syntaxguild/vibecom/mechanical/audit/README.md

# Assembly audit — v0.7.0

ตรวจเมื่อ 2026-10-17: แบบแยก **8 ชิ้น** เพิ่มฝาหลังตัวถังและถาดอุปกรณ์ถอดได้ รายงานพร้อม hash ของโมเดล/สคริปต์อยู่ใน [assembly-audit.json](assembly-audit.json)

## สิ่งที่เปลี่ยนเพื่อประกอบง่ายขึ้น

- ตัวถังแยกที่ Y=4 มม. พร้อมระยะรอยต่อ 0.35 มม. มีสกรูบริการด้านหลัง 2 จุด และสกรูฐาน 4 จุด
- ถาดมี cradle ESP32 กับแป้น ToF แยกจากฐานเท้า ยึดถาด 2 จุด พร้อมหน้าต่างสาย 18 × 30 มม. และรูรัดสาย 4 ช่อง
- เสาปิดฝาหัวอยู่ X=±34, Z=ศูนย์หัว±18 มม. เปิดทางให้จอเข้าตรงจากด้านหลัง
- ขนาดภายนอกยัง 80 × 66 × 100.8 มม.; แก้ภายในโดยรักษาหน้าตาและฮาร์ดแวร์หลัก

## ขอบเขตการตรวจ

- คู่ envelope ของอุปกรณ์/ชิ้นพิมพ์ 134 คู่ และพื้นที่สำรองหัวเสียบ
- คู่ชิ้นประกอบที่ต้องไม่ซ้อน 8 คู่ พร้อมแนวแสง ToF อ้างอิง 36 เส้น
- วาง ESP32 ลง cradle จากด้านบนขณะถาดอยู่นอกตัว
- เลื่อนชุดถาดผ่านด้านหลังที่เปิดอยู่ และตรวจการครอบเปลือกหน้ารอบฐาน/ถาดที่ประกอบไว้แล้ว
- ปิดฝาหลังตัวถังด้วยการยก 3 มม. ก่อนเลื่อนเข้าแล้วค่อยลดลง
- ทางใส่เซอร์โว ทัช ToF และจอซึ่งเป็นทางตรงจากด้านหลัง
- รูสกรูฐานและผิวรองรับหัวสกรูครบ 4 จุด

ตำแหน่งระหว่างทางเป็นการสุ่มตรวจ ไม่มีการรับรองการเคลื่อนที่ต่อเนื่องหรือการเข้าถึงด้วยมือ/เครื่องมือทุกชนิด โมเดลยังไม่รวม CAD จริงของ horn/spline, นัตทุกตัว และสายไฟทั้งหมด

## สถานะ

`geometry_gate_passed` แสดงผลเฉพาะคู่ตรวจและเส้นทางในรายงาน ส่วน `print_ready: false` คงไว้จนกว่าจะวัดอะไหล่จริงและพิมพ์ทดลองประกอบ ไม่ใช้ผลตรวจในคอมเป็นเปอร์เซ็นต์ความสำเร็จของชิ้นจริง

[Robustness checks](ROBUSTNESS.md) · [Assembly instructions](../ASSEMBLY.md) · [Reference dimensions and manufacturer links](../reference.json)

```sh
blender --background --python-exit-code 1 --python mechanical/audit_assembly.py -- --strict
python mechanical/check_exports.py
```

CI ตรวจรายงานให้ตรงไฟล์ BLEND และ source ปัจจุบัน ไม่ได้ regenerate geometry บน GitHub ประวัติก่อนแก้ยังอยู่ใน [v0.5 baseline](v0.5-baseline.json) และ Git history
