syntaxguild/vibecom/docs/HARDWARE.md

# Hardware and wiring

คู่มือนี้ใช้คำสั่งจากราก repository และสเปกอุปกรณ์เป้าหมายของ Vibecom

## ต่อจอจริง Waveshare 17344 — รุ่นอ้างอิง 2 นิ้ว 8 ขา

| ขาบนจอ | ESP32 |
| --- | --- |
| GND | GND ร่วม |
| VCC | 3V3 |
| CLK | GPIO 14 |
| DIN | GPIO 23 |
| RST | GPIO 33 |
| DC | GPIO 26 |
| CS | GPIO 27 |
| BL | 3V3 เพื่อเปิด backlight |

ใช้ `esp32vibecom` รุ่นนี้มี CS ต้องต่อ GPIO27 จอวางแนวนอน พื้นที่แสดงผล 40.8 × 30.6 มม. และ PCB 58 × 35 มม. อ้างอิง [Waveshare รุ่น 17344](https://docs.waveshare.net/2inch_LCD_Module/) สายต่อเหมือนรุ่น 15867 แต่ต้องใช้โปรไฟล์ที่ตรงกับขนาดจอ

จอ Waveshare 15867 ขนาด 1.3 นิ้วเดิมใช้ `esp32vibecom13`; จอ 7 ขาเดิมใช้ `esp32dev`: SCL/SCK →14, SDA/DIN →23, RES/RST →33, DC →26, BLK →3V3, VCC →3V3, GND →GND และไม่มี CS ไม่ต้องแก้โค้ดเพื่อย้อนใช้แบบเดิม **SDA/SCL ของจอเป็น SPI ไม่ใช่ I²C** ใช้สายสั้นและกราวด์ร่วม

หากจอดำหรือภาพผิด ตรวจสายและไฟก่อน แล้วปรับ `TFT_SPI_HZ`, `TFT_SPI_MODE`, `TFT_INVERT` ต้น `src/main.cpp` ให้ตรงโมดูล เริ่มที่ 40 MHz / SPI_MODE0 / invert=true ลดเหลือ 20 MHz หากสายมีปัญหา SPI ไม่มีการตอบรับว่าจอแสดงภาพสำเร็จ ต้องตรวจภาพจริงด้วย

## เซ็นเซอร์และเซอร์โว

| อุปกรณ์ | ขา | ESP32 |
| --- | --- | --- |
| DFR0030 / TTP223 | VCC / GND / OUT | 3V3 / GND / GPIO 4 |
| Pololu #3415 / VL53L1X (รุ่น v0.4) | VIN / GND | 3V3 / GND |
| Pololu #3415 / VL53L1X (รุ่น v0.4) | SDA / SCL | GPIO 21 / GPIO 22 |
| HC-SR04 (โปรไฟล์เดิม) | TRIG / ECHO | GPIO 5 / GPIO 19 |
| HC-SR04 (โปรไฟล์เดิม) | VCC / GND | 5V / GND |
| SG90 Digital (รุ่นอ้างอิง) / Servo เดิม | PWM | GPIO 18 |
| Servo | V+ / GND | แหล่งจ่าย 5V สำหรับมอเตอร์ / GND ร่วม |

ตั้ง TTP223 เป็น **Direct / Momentary + Active HIGH** ไม่ใช้ Toggle ตรวจจัมเปอร์ตามโมดูล และปล่อยแผ่นสัมผัสว่างอย่างน้อย 1 วินาทีตอนเปิดเครื่อง โค้ดใช้ `INPUT_PULLDOWN` และกรองสัญญาณนิ่ง 25 ms แยกแตะครั้งเดียว แตะสองครั้ง และแตะค้างได้ แต่ไม่แยกทิศทางหรือความแรงการลูบ

**รุ่นปัจจุบัน:** ใช้ carrier Pololu #3415 ที่มี regulator/level shifter ไม่ใช่ชิปเปล่า จ่าย VIN จาก **3V3** เพื่อให้ pull-up ของ SDA/SCL อยู่ที่ 3.3V ขา VDD เป็นเอาต์พุต regulator ไม่ใช่ขา VIN ขา XSHUT/GPIO1 ไม่ต้องต่อเมื่อใช้ตัวเดียว ที่อยู่ I²C เริ่มต้น `0x29`; GPIO5/19 ไม่ใช้ในโปรไฟล์ ToF [ข้อมูลและผังวงจรจาก Pololu](https://www.pololu.com/product/3415)

เริ่มทำงานต้องเห็น `Distance sensor=VL53L1X READY` โค้ดใช้ Long mode, timing budget 50 ms, วัดทุก 80 ms และตรวจ data-ready ทุก 10 ms แล้ว `read(false)` จึงไม่รอรอบวัดในลูปภาพ; I²C transaction ยังใช้เวลาจริงและตั้ง timeout 10 ms รับเฉพาะ `RangeValid` ในช่วง 40–4000 mm แล้วแปลงเป็น cm ก่อนเข้าตัวกรองเดิม ค่าผิดพลาดจะไม่กลายเป็นระยะศูนย์; เมื่อไม่มีค่าถูกต้องเกิน 400 ms จะขึ้น `Distance=unavailable` และกลับพฤติกรรมไม่มีเป้าหมาย ทัชยังใช้ได้ ถ้าเริ่มเซ็นเซอร์ไม่สำเร็จจะรายงาน ERROR ให้ตรวจสายแล้วรีสตาร์ต หลังเซ็นเซอร์รีเซ็ตหรือไฟตกขณะทำงานให้รีสตาร์ตเพื่อเริ่มเซ็นเซอร์ใหม่ ไม่ได้ทำ blocking auto-init ในลูปภาพ

ระยะ 4 เมตรเป็นค่าสูงสุดตามสภาพแสง/เป้าหมาย ไม่รับรองทุกพื้นผิว ช่องที่อกเป็นรูเปิด ไม่ปิดด้วยพลาสติกพิมพ์ทึบหรือกระจกที่ยังไม่ได้คาลิเบรต ไลบรารี [Pololu VL53L1X 1.3.1](https://github.com/pololu/vl53l1x-arduino) ที่ pin ไว้ไม่ได้จัดการ calibration สำหรับ cover glass ให้ครบ ต้องทดสอบแสง วัตถุ และช่องเปิดจริงก่อนประกอบ

**ย้อนใช้ HC-SR04:** ใช้ `pio run -e esp32vibecom_sonar -t upload` และต่อ TRIG5/ECHO19 ตามรุ่นเดิม ทั้ง ToF และ sonar จอ 2 นิ้วใช้ namespace `vibecom2` และรูปแบบค่าตั้งเดิม จึงเก็บคาลิเบรตเซอร์โว/threshold ไว้ ไม่ลบ NVS เมื่อเปลี่ยนเซ็นเซอร์ ตัวถัง HC-SR04 อยู่ใน commit `a1484a8`; ตัวถัง v0.4 ไม่มีรูรับกระบอกคู่แล้ว

HC-SR04 จริงในโปรไฟล์เก่าส่ง ECHO 5V ต้องลดระดับก่อนเข้า ESP32 เช่น ECHO → R 1 kΩ → GPIO 19 และ GPIO 19 → R 2 kΩ → GND ผัง Wokwi ปัจจุบันใช้ VL53L1X แล้ว จึงไม่มีสาย ECHO

เซอร์โวใช้แหล่งจ่ายที่จ่ายกระแสพอและกราวด์ร่วม รุ่นอ้างอิง SG90 Digital เริ่ม PWM 1000–2000 µs และช่วงคำสั่งคอ 15/75/135 จำกัดไม่เกิน 150 ตามรุ่น; แบบเดิมยังใช้ 500–2500 µs และ 0/90/180 ปรับตามกลไกจริงใน `src/hardware.h` ต้องคาลิเบรตกับเซอร์โวจริง จอไม่ได้ใช้ขาทัช ไม่มีลำโพงหรือ buzzer

จอ ILI9341 ใน Wokwi ต่อ MOSI → 23, SCK → 14, D/C → 26, CS → 27, VCC → 3V3 และ GND ร่วม ไม่ต่อ MISO ส่วน RST และ backlight ไม่ได้จำลองตามเอกสาร Wokwi
