syntaxguild/vibecom/mechanical/audit/ROBUSTNESS.md

# Digital robustness checks — v0.7.0

[ผลดิบพร้อม fingerprint](robustness.json) · [Assembly audit](README.md)

| การตรวจ | ขอบเขต |
| --- | --- |
| Head yaw | −60 ถึง +60° ทุก 10° ทั้งตำแหน่งปกติและหัวต่ำลง 0.4 มม.; ตรวจเปลือกหัวเทียบทั้งเปลือกหน้ากับฝาหลังตัวถัง |
| Position sensitivity | ขยับ ESP32 PCB, header ล่าง, PCB ToF และเคส SG90 ทีละแกน ±0.2 / ±0.4 มม. |
| Base screws | หัวตัวอย่างกว้าง 4 สูง 2 มม.; ทางใส่ 18 ตำแหน่งต่อจุด จำนวน 4 จุด |
| Head closure | แกนตัวอย่างขนาด 2 × 16 มม. จำนวน 4 จุด เทียบพื้นที่อุปกรณ์ |
| Tray closure | แกน 2 × 5 มม. กับหัวกว้าง 4 สูง 2 มม. จำนวน 2 จุด |
| Rear body closure | แกน 2 × 25 มม. กับหัวกว้าง 4 สูง 2 มม. จำนวน 2 จุด |

การดัน PCB ToF ไปด้านหน้า 0.4 มม. ชน front stop ตามตั้งใจ เพราะตำแหน่งนั่งเผื่อประมาณ 0.24 มม. เป็นการตรวจตัวหยุด ไม่ใช่ตำแหน่งประกอบที่อนุญาต รายงานแยกกรณีนี้จากการชนที่ไม่ตั้งใจ

หัวสกรูและแกนเป็นรูปทรงตัวอย่าง ไม่ใช่การรับรองสกรู M2 ทุกชนิด เกลียว ความแข็งแรง หรือแรงขัน การตรวจไม่ได้รวมสกรูจอ นัต servo/adapter และ horn จริงครบชุด

การขยับทีละแกนไม่ใช่การจำลองเครื่องพิมพ์จริง ไม่รวมหลายแกนพร้อมกัน การหดตัว ความฝืด หรือสายระหว่างหมุน จำนวนกรณีที่ผ่านจึงไม่ใช่เปอร์เซ็นต์โอกาสประกอบสำเร็จ

สิ่งที่ยังต้องทดลอง: LCD stack และตำแหน่ง active area, connector จริง, horn/spline, การงอสาย การรับน้ำหนัก/แรงบิด ทัชผ่านพลาสติก ความร้อน และการสึกหรอ

```sh
blender --background --python-exit-code 1 --python mechanical/check_robustness.py -- --strict
python mechanical/check_exports.py
```
