syntaxguild/vibecom/docs/README.th.md

# Vibecom — เพื่อนตัวเล็กบนโต๊ะ

[English overview](../README.md) · [ดาวน์โหลด v0.7.0](https://github.com/syntaxguild/vibecom/releases/tag/v0.7.0)

Vibecom จากโมเดลจริง

Vibecom เป็นหุ่นตั้งโต๊ะที่สื่ออารมณ์ผ่านดวงตาและการหันหัว ใช้ ESP32 อ่านระยะกับการสัมผัส แล้วตอบสนองด้วยท่าทางที่ออกแบบไว้ ทำงานในเครื่องด้วย state machine ไม่ต้องใช้ LLM หรือบริการคลาวด์

มี 5 อารมณ์: Idle, Happy, Angry, Love และ Sleepy แตะครั้งเดียวเพื่อเรียกความสนใจ แตะสองครั้งเพื่อเล่น แตะค้างเพื่อแสดงความรัก และมี 4 บุคลิกให้ปรับผ่าน Serial พร้อมบันทึกค่าข้ามรีสตาร์ต

## เริ่มจากตรงไหน

| สิ่งที่ต้องการ | เอกสาร |
| --- | --- |
| ต่อบอร์ด จอ เซ็นเซอร์ และเซอร์โว | [การต่อวงจร](HARDWARE.md) |
| ดูพฤติกรรม คำสั่ง Serial และระบบภาพ | [เฟิร์มแวร์](FIRMWARE.md) |
| Build / Wokwi / ทดสอบ | [Development](DEVELOPMENT.md) |
| เข้าใจแนวคิดและการออกแบบระบบ | [Architecture](ARCHITECTURE.md) |
| ดูว่าตรวจอะไรแล้วบ้าง | [Validation](VALIDATION.md) |
| เปิดโมเดลและเลือกไฟล์พิมพ์ | [คู่มือ 3D](../mechanical/README.md) |
| ดูลำดับประกอบและสกรู | [Assembly](../mechanical/ASSEMBLY.md) |
| ดูสิ่งที่เปลี่ยนในแต่ละรุ่น | [Changelog](../CHANGELOG.md) |

## สถานะปัจจุบัน

รุ่น **0.7.0** มีเฟิร์มแวร์ที่ build ได้ครบ 5 โปรไฟล์ มี host tests, custom chip VL53L1X สำหรับ Wokwi และโมเดลแยก 8 ชิ้น พร้อม BLEND/GLB/STL ขนาดรวม 80 × 66 × 100.8 มม.

แยกฝาหลังตัวถังกับถาดบอร์ดแล้ว สามารถวางบอร์ดและเตรียมสายบนถาดนอกตัวก่อนปิดเปลือก มีช่องร้อยสายกลางและช่องรัดสาย 4 ช่อง ส่วนจอใส่ตรงจากหลังหัวได้ อ่านลำดับและขนาดสกรูทดลองใน [คู่มือประกอบ](../mechanical/ASSEMBLY.md)

ภาพแนว blueprint ของรุ่นปัจจุบัน

ภาพ blueprint ใช้ AI สร้างจากภาพ CAD ปัจจุบันเพื่ออธิบายงาน ไม่ใช่แบบผลิต ให้ยึด STL และมิติใน reference เป็นหลัก

ผ่านการตรวจการชนในคอม ทางใส่ตัวอย่าง การหมุนหัว และทางใส่หัวสกรูตามขอบเขตที่ระบุแล้ว ผู้ใช้ยืนยันว่า Wokwi เปิดชิป VL53L1X และรันได้ แต่ยังไม่ได้พิมพ์หรือประกอบกับอะไหล่จริง จึงต้องวัดหัวเสียบ ความหนาจอ horn และเดินสายจริงก่อนสั่งพิมพ์ชุดสำเร็จ ผลตรวจในคอมไม่ใช่เปอร์เซ็นต์โอกาสประกอบสำเร็จ

## คำสั่งเริ่มต้น

```sh
pio run -e esp32vibecom
pio run -e esp32sim
```

โปรไฟล์แรกสำหรับฮาร์ดแวร์อ้างอิง โปรไฟล์หลังสำหรับ Wokwi ใน VS Code อ่านวิธีต่อไฟและกราวด์ร่วมใน [Hardware](HARDWARE.md) ก่อนอัปโหลดลงบอร์ดจริง
