syntaxguild/vibecom/docs/FIRMWARE.md

# Firmware behavior and rendering

## สีหน้าและพฤติกรรม

| เงื่อนไข | ภาพใบหน้า | คอ |
| --- | --- | --- |
| Idle: อยู่นอกช่วงทักทาย | ตาทึบสีฟ้ามินต์ กลอกตา หายใจและกะพริบ | ตามสายตาเล็กน้อย |
| Sleepy: ไม่มีปฏิสัมพันธ์ตามเวลาที่ตั้ง (เริ่ม 10 วินาที) | ตาปรือสีม่วงหม่น มี Zz ลอยขึ้น | กลับ `neck_center` |
| Happy: ระยะอยู่ระหว่าง `near` และ `far` | ตายิ้มกว้างสีทอง ขยับกระฉับกระเฉง แก้มอุ่น | ส่ายนุ่มนวล / ทักทายเมื่อเดินเข้ามา |
| Angry: ใกล้กว่า `near` | ตาคมสีคอรัล สั่นเบา ๆ ไม่มีตายิ้ม แก้ม หรือหัวใจจากอารมณ์ก่อนหน้า | หันหนีถึง `neck_max` ที่คาลิเบรตไว้ |
| Love: ขณะสัมผัส สำคัญสูงสุด | ตาปรือยิ้มอ่อนสีชมพู เอนหน้าและมีแก้ม ต่างจาก Happy | หันใกล้ `neck_center + 8°` ขยับช้า ๆ ±3° ภายในช่วงคอ |
| ไม่มีค่าระยะที่ถูกต้องต่อเนื่อง | คงระยะเดิมได้ไม่เกิน 400 ms ก่อนเปลี่ยนกลับ Idle ยกเว้น Love / ท่าเล่น | ตามโหมดปัจจุบัน |

ระยะใช้ค่ากลางของ 3 ตัวอย่าง (วัดทุก 80 ms) และยืนยันโซนใหม่ต่อเนื่อง 160 ms ค่าเริ่มต้นเข้า Angry เมื่อ <15 cm และออกเมื่อ ≥17 cm เข้า Happy เมื่อ ≤50 cm และออกเมื่อ >53 cm จึงไม่สลับสีหน้าไปมาที่ขอบเขต ถ้าสัญญาณหายครบ 400 ms จะทิ้งหน้าต่างเก่าและรอ 3 ตัวอย่างใหม่ การเปลี่ยนอารมณ์หลังสัญญาณหายยังผ่านช่วงยืนยัน 160 ms ด้วย

การเข้าใกล้ภายใน `far` สัมผัส หรือระยะที่กรองแล้วเปลี่ยนจากจุดอ้างอิงอย่างน้อย 4 cm ปลุกจากอาการง่วง การเอนหน้าเป็นภาพบนจอ เซอร์โวหนึ่งตัวใช้หันคอ ไม่ได้ติดตามตำแหน่งซ้าย–ขวาของคน

| การสัมผัส / เหตุการณ์ | พฤติกรรม |
| --- | --- |
| แตะสั้น <500 ms ครั้งเดียว | รอ 320 ms หลังปล่อยเพื่อแยกจากสองครั้ง แล้วเงยตาและหันคอเล็กน้อย 0.9 วินาที |
| แตะสั้นสองครั้ง เริ่มครั้งที่สองภายใน 320 ms หลังปล่อยครั้งแรก | เล่นด้วย ตาสีทองและส่ายคอ 1.8 วินาที |
| แตะค้าง ≥500 ms | Love ระหว่างแตะ และค้างต่อ 1.2 วินาทีหลังปล่อยก่อนค่อย ๆ คลายท่า |
| เดินเข้าช่วง Happy จาก Idle | เหลือบมองแล้วส่ายคอทักทาย 1.6 วินาที เว้นอย่างน้อย 8 วินาทีก่อนทักครั้งใหม่ |
| ปลุกจากหลับ | ค่อย ๆ ลืมตา 1.1 วินาที |

ขณะแตะทุกแบบจะเป็น Love ทันทีหลัง debounce การแตะสั้นไม่ค้าง Love 1.2 วินาทีหลังปล่อย ท่าเล่น/ทักทาย/สนใจถูกยกเลิกเมื่อเข้า Angry และการสัมผัสครั้งใหม่ขัดจังหวะท่าเดิมได้

## ตั้งค่าผ่าน Serial และจำค่าหลังรีสตาร์ต

เปิด Serial Monitor ที่ 115200 baud ส่งคำสั่ง ASCII ทีละบรรทัดด้วย Enter (`LF` หรือ `CRLF`) ไม่เกิน 95 ตัวอักษร:

```text
help
show
profile affectionate
set sleep 15
set near 12
set far 60
set neck_min 30
set neck_max 135
set neck_center 75
save
```

| คำสั่ง | ความหมาย |
| --- | --- |
| `profile normal` | ระยะ 15/50 cm หลับหลัง 10 วินาที |
| `profile affectionate` | ขี้อ้อน ระยะ 12/65 cm หลับหลัง 10 วินาที |
| `profile sleepy` | ขี้เซา หลับหลัง 6 วินาที และส่ายคอ Happy เบาลง ระยะ 15/50 cm |
| `profile grumpy` | ขี้หงุดหงิด ระยะ 22/45 cm หลับหลัง 10 วินาที |
| `set sleep N` | เวลาหลับ 3–600 วินาที |
| `set near N`, `set far N` | `near` 5–80 cm, `far` ไม่เกิน 200 cm และต้องห่าง `near` อย่างน้อย 5 cm |
| `set neck_min N`, `set neck_center N`, `set neck_max N` | ค่าจำนวนเต็ม 0–150 สำหรับรุ่นอ้างอิง / 0–180 แบบเดิม ต้องเรียง `min < center < max` |
| `show` / `help` | แสดงค่าปัจจุบัน / คำสั่ง |
| `save` | บันทึกค่าปัจจุบันใน NVS ด้วย Preferences |
| `reset` | คืนค่าเริ่มต้นใน RAM; ส่ง `save` อีกครั้งหากต้องการบันทึกค่าเริ่มต้น |

ค่าที่แก้มีผลทันที แต่เขียน flash เฉพาะเมื่อส่ง `save` เท่านั้น รุ่น 2 นิ้วใช้ namespace `vibecom2`, รุ่น 1.3 นิ้วใช้ `vibecomref`, แบบ 7 ขาใช้ `deskbot` เพื่อเก็บคาลิเบรตแต่ละรุ่นแยกกัน `profile` เปลี่ยนระยะและเวลาหลับ แต่เก็บมุมคอที่คาลิเบรตไว้ คำสั่งผิด/ค่าผิดช่วงถูกปฏิเสธทั้งคำสั่ง บัฟเฟอร์เต็มจะทิ้งทั้งบรรทัด ข้อมูลที่บันทึกใช้รูปแบบมีเวอร์ชันใน key เดียวและตรวจความถูกต้องเมื่อโหลด หากไม่มีข้อมูลหรืออ่านไม่ได้จะใช้ค่าเริ่มต้น

ทุกท่าถูกจำกัดให้อยู่ในช่วงคอที่ตั้งไว้ รวมมุมเริ่มต้นตอนเปิดเครื่อง ปรับช่วงนี้ให้เหมาะกับกลไกก่อนใช้งานจริง การส่งคำสั่งหรือ `save` อาจหยุดภาพชั่วครู่ จึงประมวลผลเฉพาะช่วงที่ไม่ได้จับ ECHO

ทุกโหมดไม่มีปากเสี้ยววงกลม ใช้ทรงตา สี และการขยับสื่ออารมณ์แทน สถานะ Angry คุมตาทันที ไม่รอ `angryBlend` เกิน 0.5 และระงับตายิ้ม หัวใจ แก้มจากค่า Happy/Love ที่กำลังจางออก

## ความลื่นและหน่วยความจำ

วาดด้วย Adafruit GFX ลง indexed canvas สองชุด ชุดละ 240×160 = 38,400 bytes รวม **76,800 bytes ที่จองคงที่ใน RAM ตั้งแต่ build** ไม่ใช้ `malloc()` จองบัฟเฟอร์ก้อนใหญ่ใน global constructor จึงไม่มีเงื่อนไขจอถูกปิดจากการจองก้อนนั้นล้มเหลวแบบรุ่นก่อน ตัวเลข RAM ตอน build รวมบัฟเฟอร์ทั้งสองแล้ว

แต่ละเฟรมมี palette 5 สี เก็บเป็น RGB565 เต็มความแม่นยำ รวม 20 bytes สำหรับสองเฟรม ก่อนส่งจอแปลงดัชนีสีครั้งละ 8 แถวตรรกะ รุ่น 2 นิ้วขยาย 4:3 เป็นแถบ 320×10/11 pixel ใช้บัฟเฟอร์ RGB565 สูงสุด 7,040 bytes รวมพื้นที่ pixel / palette / ส่งภาพ **83,860 bytes** บวก metadata เล็กน้อย; รุ่นจอเดิมใช้บัฟเฟอร์ 3,840 bytes รวม 80,660 bytes ความละเอียด สี และเอฟเฟกต์เดิมคงอยู่ ไม่ได้ลดเป็นสี RGB332

พื้นที่ตรรกะใบหน้า 240×160 ขยายเป็น 320×214 กลางจอ 320×240 สำหรับจอ 2 นิ้ว; รุ่น 1.3 นิ้วยังเป็น 240×160 กลางจอ 240×240 พื้นที่ดำรอบหน้าล้างครั้งเดียว ภาพที่กำลังส่งไม่ถูกแก้ ขณะอีกบัฟเฟอร์วาดเฟรมใหม่ จึงไม่เกิดเฟรมดำจากการ clear จอแล้ววาดทีละชิ้น

เปรียบเทียบทั้งดัชนีและ palette กับภาพที่ส่งครบแล้วก่อนนำบัฟเฟอร์เก่ากลับมาวาด จึงยังส่งสีใหม่แม้ทรงตาไม่เปลี่ยน ส่งเฉพาะแถบที่เปลี่ยนผ่าน hardware SPI รุ่น 2 นิ้วครั้งละ 10/11 แถว = 6,400/7,040 bytes เวลาบิตบนสายประมาณ **1.28–1.41 ms ที่ 40 MHz** ต่อช่วง กรณีเปลี่ยนทั้งพื้นที่หน้าคือประมาณ **27.39 ms**; รุ่นจอเดิม 0.77 ms ต่อแถบ และ 15.36 ms ทั้งหน้า ยังไม่รวมเวลาวาด แปลงสี เรียกไลบรารี และบริการอินพุต HC-SR04 จับ ECHO ด้วย interrupt เริ่มวัดทุก 80 ms และไม่แทรก SPI/Serial ระหว่าง TRIG 10 µs

เป้าหมายสร้างภาพตรรกะ 60 Hz แต่ **ไม่รับรองจอจริง 60 FPS** จอ 2 นิ้วที่เปลี่ยนภาพเต็มพื้นที่ถูกจำกัดด้วยเวลาสาย SPI ประมาณ 36 ภาพ/วินาที ก่อนรวม overhead ต้องวัดกับโมดูลและสายจริง การส่งแถบไม่ได้ซิงก์ TE ของจอ จึงอาจมีรอยฉีกขณะเคลื่อนไหว Simulator ไม่ใช้วัดความเร็วฮาร์ดแวร์

Serial แสดง `FPS draw` (สร้างภาพ), `TFT` (ภาพเป้าหมายที่แสดงครบ รวมภาพที่เหมือนเดิมจนไม่ต้องส่งซ้ำ), `skipped` (เฟรมใหม่แทนเฟรมที่ยังไม่เริ่มส่ง) และ `SPI max` (เวลาส่งช่วงที่นานที่สุดตั้งแต่เปิดเครื่อง) ค่า TFT เป็นอัตราภาพเป้าหมายที่สำเร็จ ไม่ใช่อัตรา refresh ภายในแผง LCD
