syntaxguild/vibecom/mechanical/exports/05_base_cover.stl

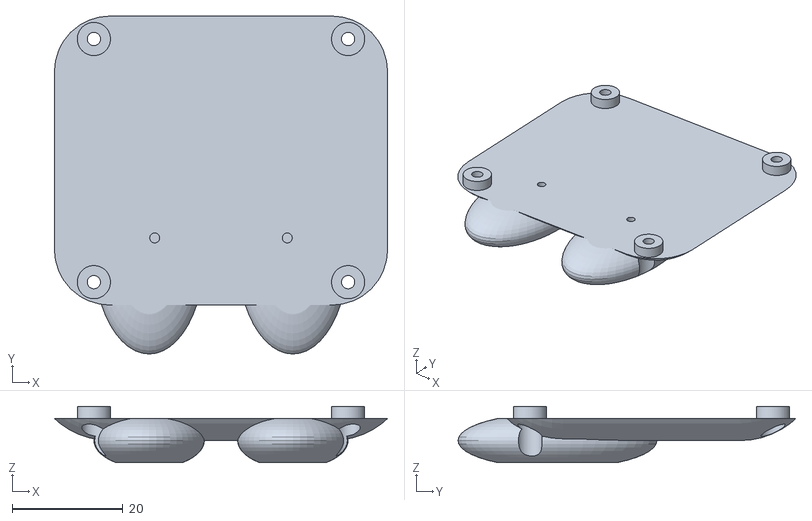
[picture p9: CAD file, 2026-10-17]
mechanical/exports/05_base_cover.stl
60.3 x 61.2 x 10.2
