syntaxguild/vibecom/mechanical/exports/02_head_front.stl

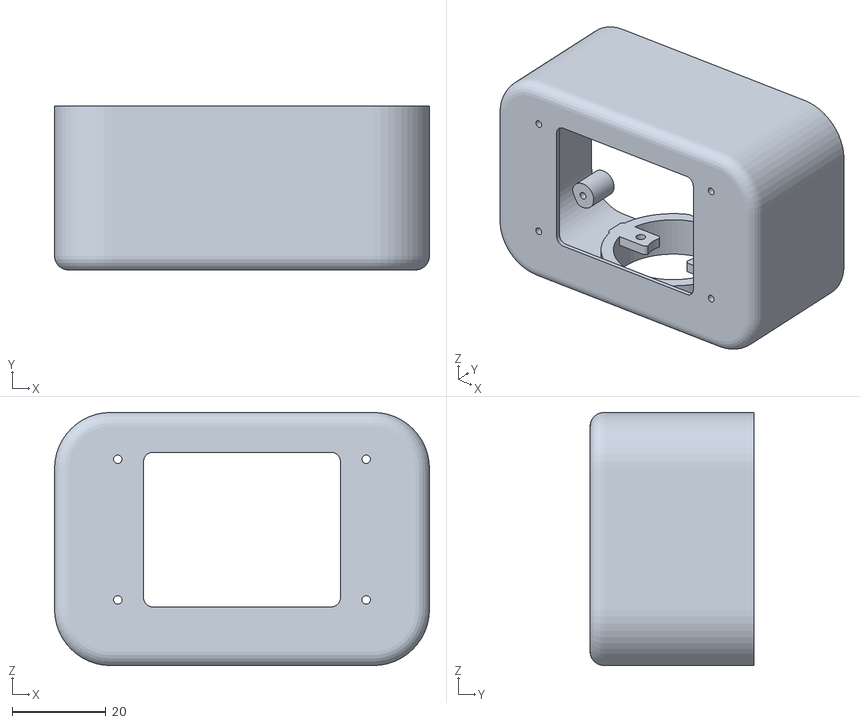
[picture p10: CAD file, 2026-10-17]
mechanical/exports/02_head_front.stl
80.0 x 35.0 x 54.0
