syntaxguild/vibecom/mechanical/exports/07_body_rear.stl

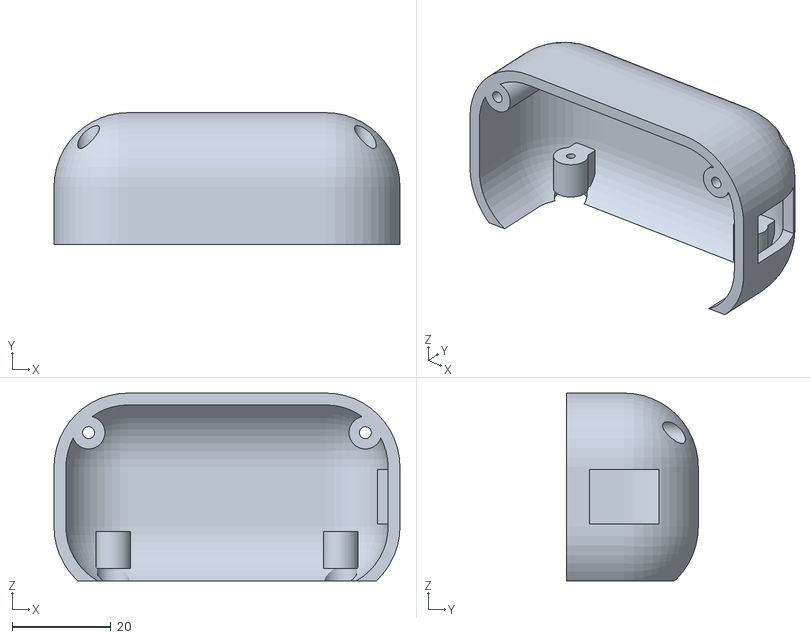
[picture p11: CAD file, 2026-10-17]
mechanical/exports/07_body_rear.stl
70.0 x 26.7 x 38.0
