syntaxguild/vibecom/mechanical/exports/08_electronics_tray.stl

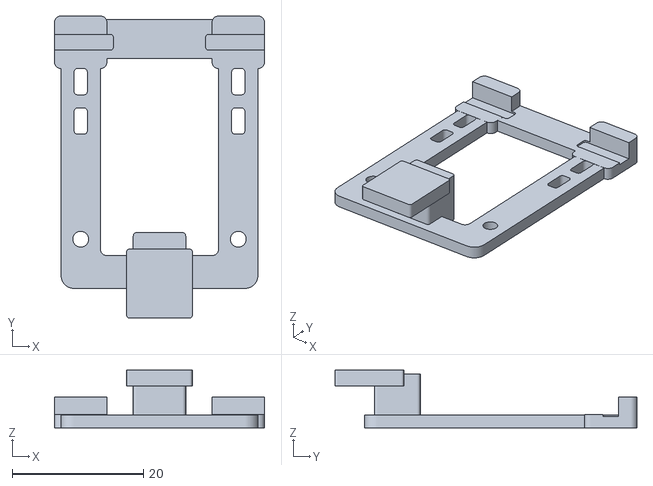
[picture p12: CAD file, 2026-10-17]
mechanical/exports/08_electronics_tray.stl
32.0 x 46.0 x 8.80
