syntaxguild/vibecom/mechanical/exports/01_head_rear.stl

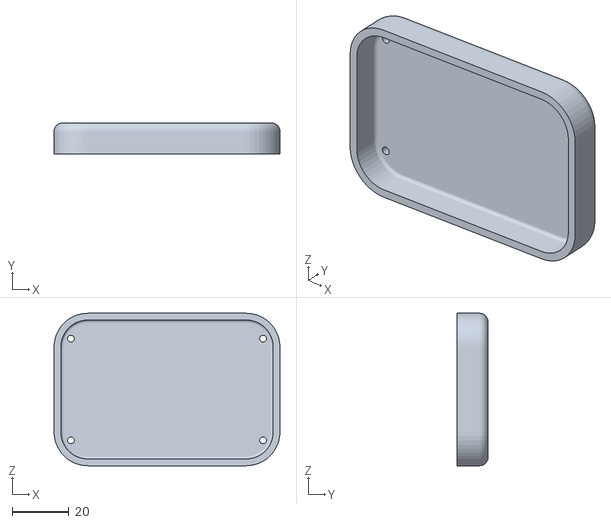
[picture p13: CAD file, 2026-10-17]
mechanical/exports/01_head_rear.stl
80.0 x 11.0 x 54.0
