syntaxguild/vibecom/mechanical/exports/04_body_shell.stl

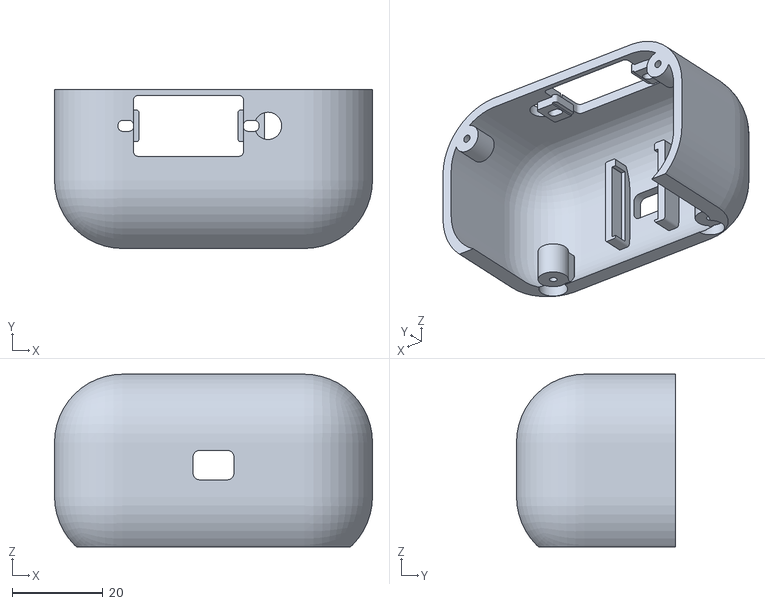
[picture p14: CAD file, 2026-10-17]
mechanical/exports/04_body_shell.stl
70.0 x 35.0 x 38.0
