syntaxguild/vibecom/mechanical/exports/03_face_insert.stl

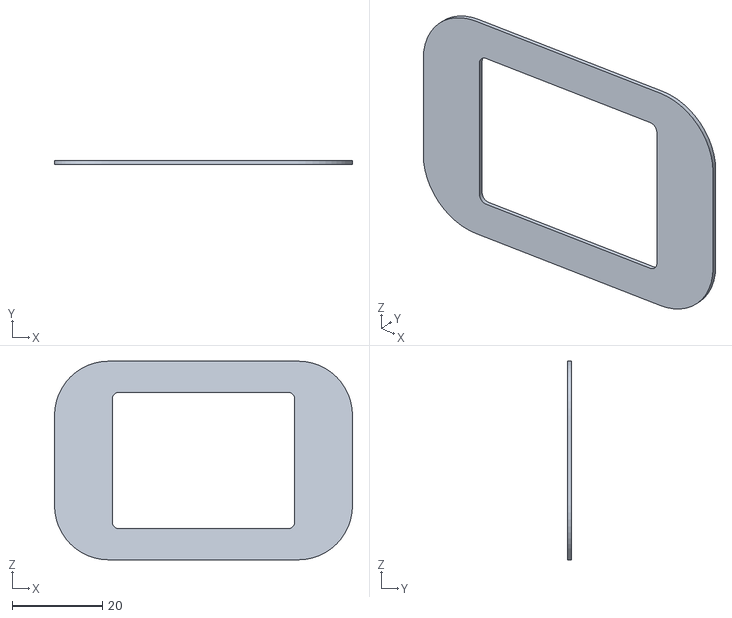
[picture p15: CAD file, 2026-10-16]
mechanical/exports/03_face_insert.stl
66.0 x 0.8 x 44.0
