syntaxguild/vibecom/mechanical/exports/06_neck_horn_adapter.stl

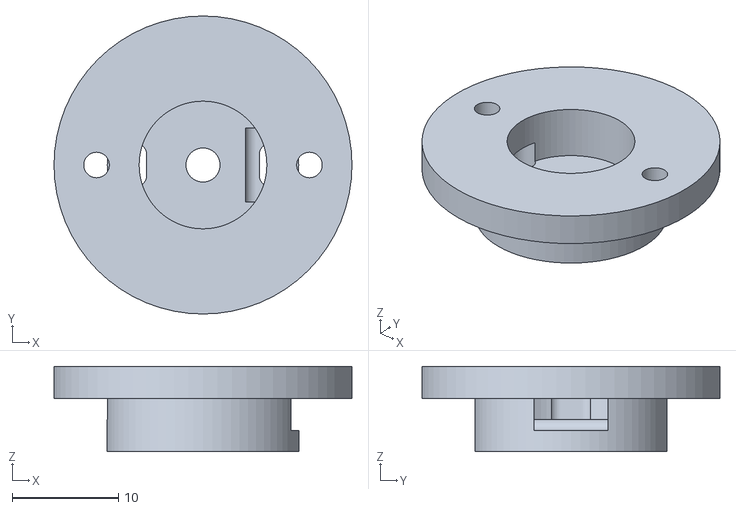
[picture p16: CAD file, 2026-10-16]
mechanical/exports/06_neck_horn_adapter.stl
28.0 x 28.0 x 8.00
