syntaxguild/vibecom/(list of files, cad)

Other CAD files:
mechanical/exports/vibecom.blend
