syntaxguild/vibecom/mechanical/ASSEMBLY.md

# Vibecom v0.7.0 — ประกอบและเปิดซ่อม

ใช้ STL ใหม่ทั้ง **8 ชิ้น** หน่วยมิลลิเมตร scale 100% รุ่นนี้เพิ่มฝาหลังตัวถังและถาดอุปกรณ์ ห้ามผสมฐาน/ฝาหรือชิ้นหัวจากรุ่นก่อน

## ลำดับประกอบ

1. **ลองวงจรบนโต๊ะก่อน:** ทดสอบจอ ทัช ToF และเซอร์โว ตรวจการต่อไฟ/กราวด์และตั้งมุมศูนย์ก่อนยึดหัว
2. **เตรียมถาดข้างนอก:** วาง ESP32 ลงใน cradle ที่เปิดด้านบนของ `08_electronics_tray` หัน USB ไปขวาและส่วนเสาอากาศไปซ้าย เตรียมหัวเสียบ/สายขณะยังเข้าถึงบอร์ดได้ ถาดมีช่องกลางและรูรัดสาย 4 ช่อง ไม่ต้องกองสายยาวในตัว
3. **ยึดถาดกับฐาน:** วางถาดบน `05_base_cover` และใส่สกรูถาด 2 จุดก่อนปิดเปลือก จะเข้าถึงสกรูได้สะดวกกว่าหลังใส่ตัวถัง ขนาดสกรูต้องเทียบของจริงตามตาราง
4. **ครอบเปลือกหน้ารอบชุดฐาน/ถาด:** ยังไม่ใส่เซอร์โวและหัว ยก `04_body_shell` สูงจากตำแหน่งสุดท้ายประมาณ 3 มม. เลื่อนเข้าจากด้านหน้า แล้วลดลงให้แป้นฐานเข้าช่อง ยึดสกรูฐานด้านหน้า 2 ตัวก่อน ฝาหลังตัวถังยังเปิดอยู่
5. **ใส่ ToF และเซอร์โว:** วาง PCB ToF จากด้านใน เลื่อนเข้ารางด้านหน้าจนอยู่บนแป้นถาด โดยแถวขาต่ออยู่ทางซ้ายเมื่อมองหน้าหุ่น ยึดด้านหลังโดยไม่ปิดเลนส์ จากนั้นใส่ SG90 เข้าที่ roof spacer และเทียบรู tab กับร่องปรับ ยึดก่อนประกอบ horn
6. **เตรียมหัว:** เปิดฝาหลังหัว ใส่ทัชในแนวต่ำกว่าหลังคา 2.8 มม. แล้วค่อยยกขึ้นใต้ช่องบาง จอเลื่อนตรงเข้าจากด้านหลังได้แล้ว ไม่ต้องเอียง 45° เหมือนรุ่นก่อน ตรวจความหนา stack และผิวหน้าจอก่อนยึด
7. **เก็บสายและปิดตัว:** เดินสายจอ/ทัชผ่านช่องข้อต่อซ่อนด้านข้าง เผื่อห่วงบริการให้หมุนได้ ทดสอบก่อนรัดสายถาวร ยก `07_body_rear` สูงจากฐานราว 3 มม. เลื่อนจากด้านหลังเข้ามา แล้วลดลงให้ช่องแป้นตรงกับฐาน ยึดสกรูบริการฝาหลัง 2 จุดและสกรูฐานด้านหลัง 2 จุด ก่อนติดตั้งหัวซึ่งอยู่เหนือรอยต่อ
8. **ติดหัวและทดสอบ:** ใช้ horn และสกรู spline จริง ยึด adapter กับหัวแล้วทดสอบการหมุนช้า ๆ ในช่วงสั้นก่อน ไม่ให้สายถูกหนีบ/ตึง จึงค่อยปิดฝาหลังหัวและติดแผ่นหน้าดำ

ลำดับนี้เป็นแบบจำลองการประกอบตาม envelope ที่วางไว้ ไม่มีการจำลองมือ สายทุกเส้น หรือไขควงครบชุด หากชิ้นจริงติด ให้หยุดวัดเทียบ ไม่ฝืนพลาสติกหรือบอร์ด

## จุดยึดและสกรู

| จุด | จำนวน | ขนาด/วิธีเริ่มต้นสำหรับทดลอง |
| --- | --- | --- |
| ฝาหลังหัว | 4 | รูผ่าน 2.4 มม., pilot 1.8 มม.; เริ่มเทียบสกรูยึดพลาสติกขนาดประมาณ M2 × 16 มม. |
| ฐาน ↔ ตัวถัง | 4 | รูผ่าน 2.4 มม., บ่าหัว 4.4 มม.; เริ่มเทียบ M2 × 8 มม. และหัวไม่เกินตัวอย่างที่ทดสอบ |
| ถาด ↔ ฐาน | 2 | รูถาด 2.4 มม., pilot ฐาน 1.8 มม.; ตัวอย่างแกน M2 × 5 มม. และหัวกว้าง 4 สูง 2 มม. ต้องวัดความลึกเกลียวจริง |
| ฝาหลังตัวถัง ↔ เปลือกหน้า | 2 | รูผ่าน 2.4 มม., บ่าหัว 4.4 มม., pilot ด้านหน้า 1.8 มม.; แกนตัวอย่าง M2 × 25 มม. จุดนั่งหัวอยู่ Y=23.5 มม. |
| จอ | 4 | รู 53 × 30 มม.; เสารอง pilot 1.8 มม. ความยาวสกรูขึ้นกับ PCB/stack จริง |
| Servo กับเปลือกหน้า | 2 | ร่องปรับ 3.4 × 2.4 มม.; ต้องวัดรู tab และเลือกสกรู/นัตที่เข้าถึงได้จริง |
| Adapter กับหัว | 2 | รูผ่าน 2.4 มม.; ใช้สกรู/นัตให้เหมาะกับพื้นที่หลังสะพาน ไม่มี nut trap ที่รับรองแล้ว |
| Horn | ตาม horn จริง | ใช้ horn และสกรู spline เดิม ห้ามเดาขนาด spline พิมพ์ทับเอง |

ตัวเลขเป็นขนาดสำหรับทดลอง ไม่ใช่ BOM พร้อมซื้อจำนวนมาก สกรูเกลียวเครื่องไม่เหมือนสกรูยึดพลาสติก ต้องลอง pilot กับวัสดุพิมพ์จริงก่อนขันเต็มแรง ฝาหัว/ฐาน/ถาด/ฝาตัวใช้ pilot ไม่มีนัตฝัง ส่วนจุดผ่าน servo/adapter ต้องเทียบนัตและหัวสกรูจริงเพิ่ม

กรอบหน้าดำใช้เทปบางหรือกาวที่เข้ากับวัสดุหลังตรวจ fit แล้ว บอร์ดใช้ที่รองร่วมกับเทปยึด PCB หรือวิธียึดถอดได้ ห้ามกาวปิดหน้าเลนส์ พื้นที่ทัช หรืออุปกรณ์บนบอร์ด อย่าทากาวปิดฝาบริการ

## สายและการเปิดซ่อม

ใช้สายอ่อนตัดความยาวเหมาะสม หันหัวเสียบเข้าด้านใน เตรียมสายที่ถาดนอกตัวก่อนครอบเปลือก ช่องกลางถาดเปิด 18 × 30 มม. และมีช่องรัดสาย 4 ช่องขนาด 2 × 4 มม. ช่องสายขึ้นหัวเส้นผ่านศูนย์กลาง 6 มม. เป็นพื้นที่นำทาง ไม่ใช่การรับรองรัศมีงอสายทุกชนิด

เปิดฝาหลังตัวได้โดยถอดสกรูบริการ 2 ตัวกับสกรูฐานด้านหลัง 2 ตัว หากถอดขณะหัวติดอยู่ ให้ยก/ถอดหัวก่อนเมื่อช่องสูง 3 มม. ไม่พอ แล้วจึงยกฝาและเลื่อนออก ถ้าจะยกถาดออก ให้ถอดเปลือกหน้าหรือเปิดชุดฐานเพื่อเข้าถึงสกรูถาด 2 จุด ห้ามดึงถาดที่ยังมีสกรูหรือสายค้าง

ยังไม่มีแบตเตอรี่หรือวงจรชาร์จที่จัดตำแหน่งไว้ในแบบนี้ ทดสอบความหนาจอ horn/spline หัวเสียบ การเดินสาย และทัชผ่านวัสดุด้วยชิ้นทดลองก่อนงานชุดสำเร็จ
