syntaxguild/vibecom/mechanical/exports/vibecom-assembled.png

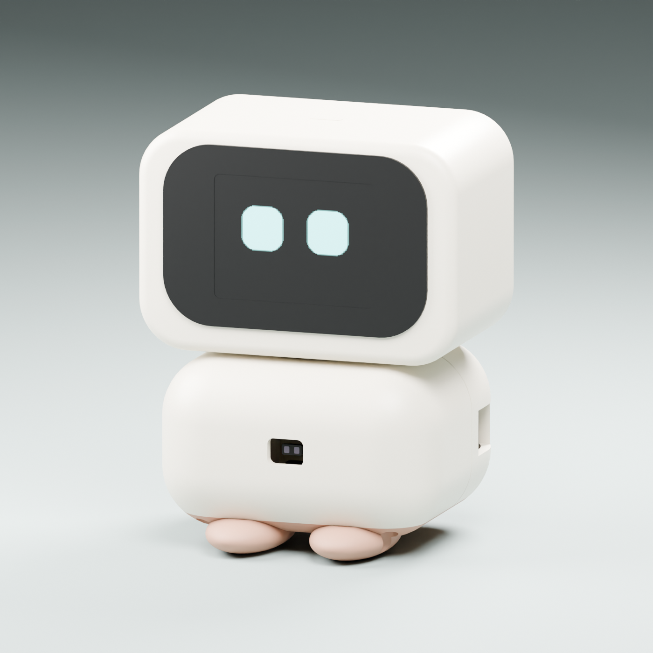
mechanical/exports/vibecom-assembled.png
