syntaxguild/vibecom/(commit log)

2026-10-15 fix: make petting animation softer and consistent
    [main.cpp]
2026-10-15 feat: add SPI color display and fix angry expressions
    [face.h, face_render.cpp, main.cpp, run_render_checks.py]
2026-10-15 fix: use static display buffers and remove cartoon mouth
    [face.h, face_render.cpp, main.cpp]
2026-10-15 fix: show simulator display in landscape
    [main.cpp]
2026-10-16 feat: add Vibecom enclosure and reference hardware
    [01_head_rear.stl, 02_head_front.stl, 03_face_insert.stl, 04_body_shell.stl, 05_base_cover.stl, 06_neck_horn_adapter.stl, vibecom.blend]
2026-10-16 feat: soften Vibecom and enlarge its face
    [01_head_rear.stl, 02_head_front.stl, 03_face_insert.stl, 04_body_shell.stl, 05_base_cover.stl, 06_neck_horn_adapter.stl, vibecom.blend]
2026-10-16 feat: conceal Vibecom neck inside the head
    [01_head_rear.stl, 02_head_front.stl, 03_face_insert.stl, 05_base_cover.stl, vibecom.blend]
2026-10-16 feat: replace Vibecom sonar with compact VL53L1X sensor
    [04_body_shell.stl, 05_base_cover.stl, vibecom.blend]
2026-10-16 fix: use VL53L1X I2C model in Wokwi
    [run_render_checks.py, tof_sim_checks.cpp]
2026-10-16 design: reshape Vibecom as a warm Mochi companion
    [01_head_rear.stl, 02_head_front.stl, 03_face_insert.stl, 04_body_shell.stl, 05_base_cover.stl, vibecom.blend]
2026-10-16 docs: audit enclosure fit against manufacturer drawings
2026-10-16 fix: clear enclosure hardware and assembly paths
    [02_head_front.stl, 04_body_shell.stl, 05_base_cover.stl, vibecom.blend]
2026-10-16 fix: verify motion and screw insertion clearances
    [04_body_shell.stl, 05_base_cover.stl, vibecom.blend]
2026-10-17 feat: release serviceable enclosure and portfolio blueprint
    [01_head_rear.stl, 02_head_front.stl, 04_body_shell.stl, 05_base_cover.stl, 07_body_rear.stl, 08_electronics_tray.stl, vibecom.blend]
